Graimalkin/all_the_things_best_projects/halloween-yard-speakers/case/previews/iso_stl.png

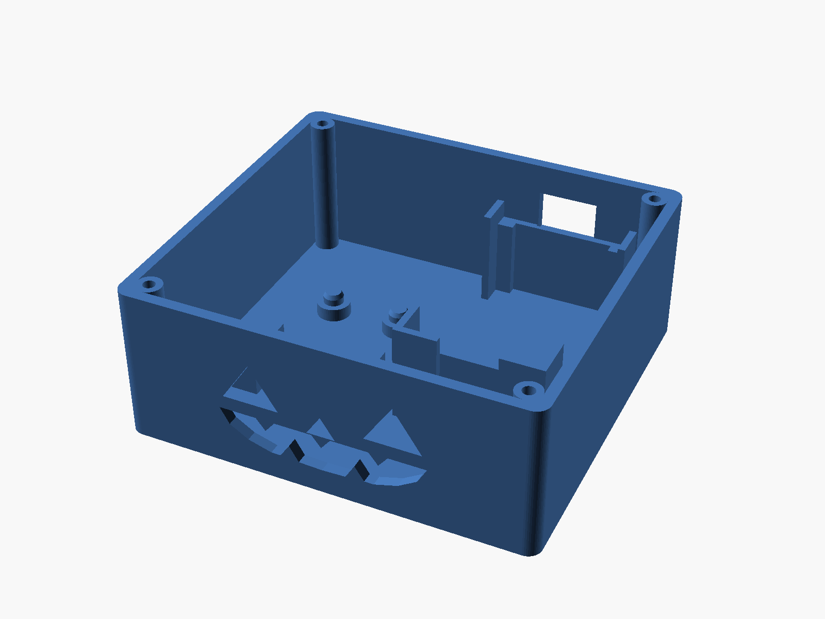
halloween-yard-speakers/case/previews/iso_stl.png
