Graimalkin/all_the_things_best_projects/halloween-yard-speakers/case/previews/top_open.png

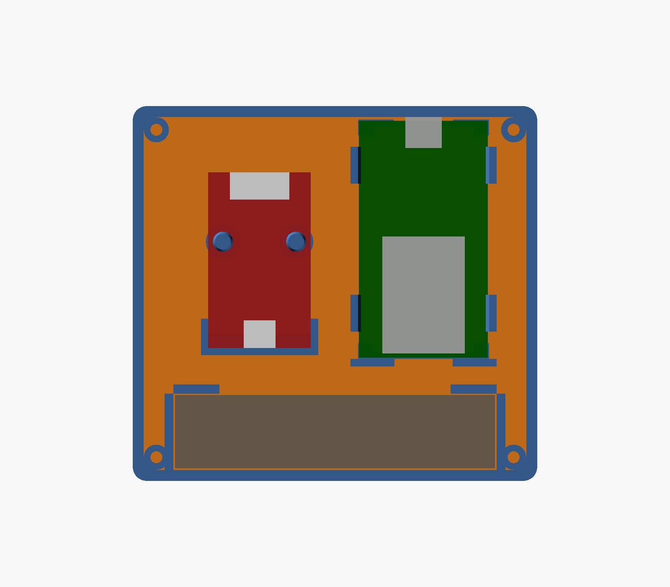
halloween-yard-speakers/case/previews/top_open.png
