Graimalkin/all_the_things_best_projects/halloween-yard-speakers/case/spooky_box_slots.stl

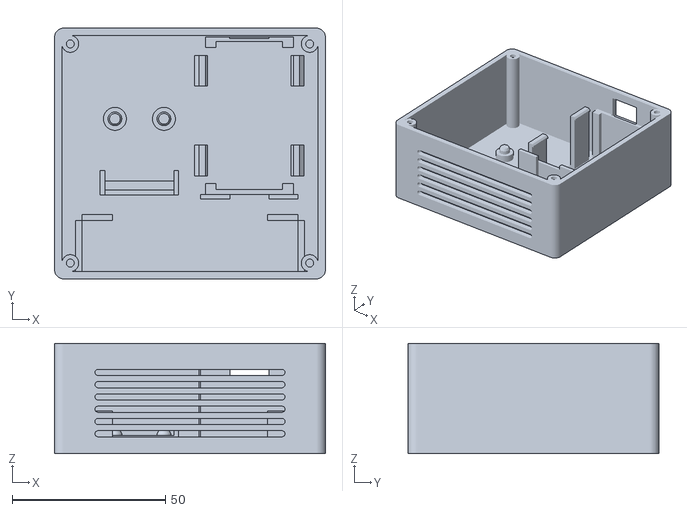
[picture p6: CAD file, 2026-11-12]
halloween-yard-speakers/case/spooky_box_slots.stl
88.4 x 81.8 x 36.0
