Graimalkin/all_the_things_best_projects/halloween-yard-speakers/case/spooky_lid.stl

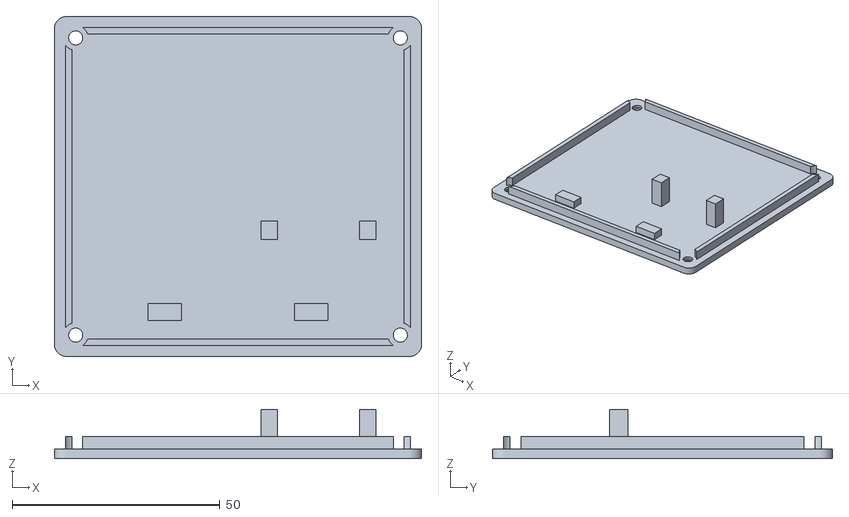
[picture p7: CAD file, 2026-11-12]
halloween-yard-speakers/case/spooky_lid.stl
88.4 x 81.8 x 11.9
