Graimalkin/all_the_things_best_projects/halloween-yard-speakers/case/spooky_box_pumpkin.stl

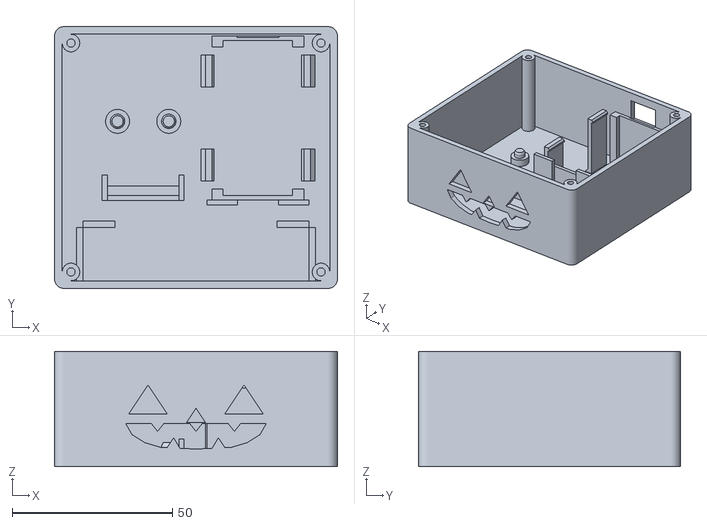
[picture p8: CAD file, 2026-11-12]
halloween-yard-speakers/case/spooky_box_pumpkin.stl
88.4 x 81.8 x 36.0
