Graimalkin/all_the_things_best_projects/halloween-yard-speakers/case/previews/lid_print.png

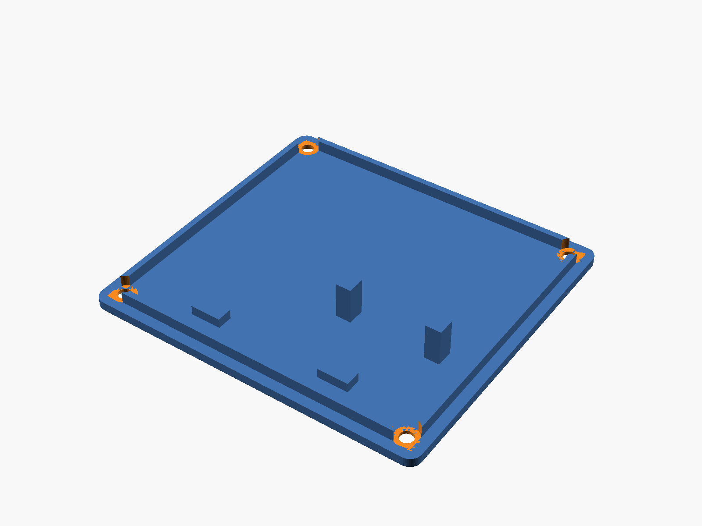
halloween-yard-speakers/case/previews/lid_print.png
