Graimalkin/all_the_things_best_projects/(commit log)

2026-11-12 Add the Halloween yard speakers build
    ESPHome config for an ESP32 + NS4168 I2S amp that shows up in Home
    Assistant as a media player, with the secrets template, baked-in test
    tone, wiring diagram, and the OpenSCAD case with STLs.
    [spooky_box_pumpkin.stl, spooky_box_slots.stl, spooky_lid.stl, spooky_speaker_case.scad]
2026-11-12 Yard speaker case: re-export the STLs from the v3 source
    The STLs were the v2 export; the .scad had since gained the v3 change
    (ESP32 pocket 1 mm shorter, thicker snap clips with a root gusset).
    Exported with OpenSCAD 2021.01. Outer size is unchanged and the lid
    geometry is identical.
    [spooky_box_pumpkin.stl, spooky_box_slots.stl, spooky_lid.stl]
